mutuleasadavid/Audiofrequency-Oscillator/poze layout/TOPSMTOP.jpg

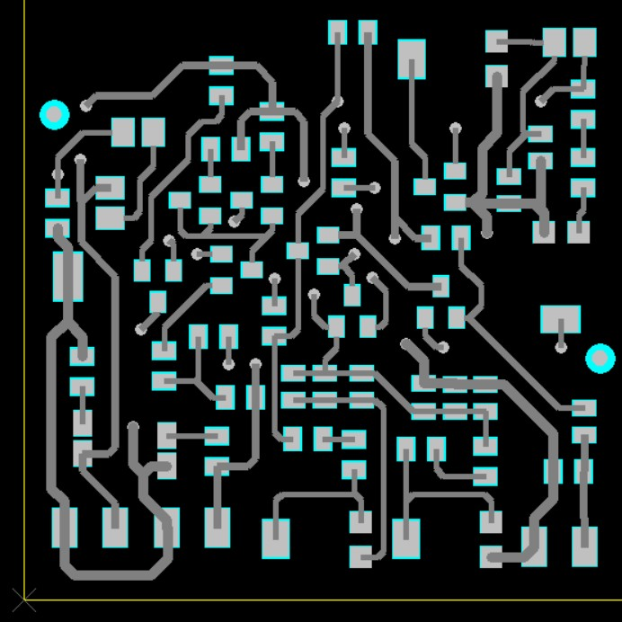
poze layout/TOPSMTOP.jpg
