mutuleasadavid/Audiofrequency-Oscillator/README.md

# Audiofrequency-Oscillator
I designed an analog audiofrequency oscillator with variable frequency and amplitude. I also projected the PCB for the SMD components.
