mutuleasadavid/Audiofrequency-Oscillator/Documentation.pdf

Universitatea Națională de Știință și Tehnologie POLITEHNICA București Facultatea E.T.T.I.
Anul universitar 2025-2026

# Circuite electronice fundamentale 2 - Proiect

# Proiectarea și realizarea

# unui oscilator de audiofrecvență

# cu semnal sinusoidal

N=3

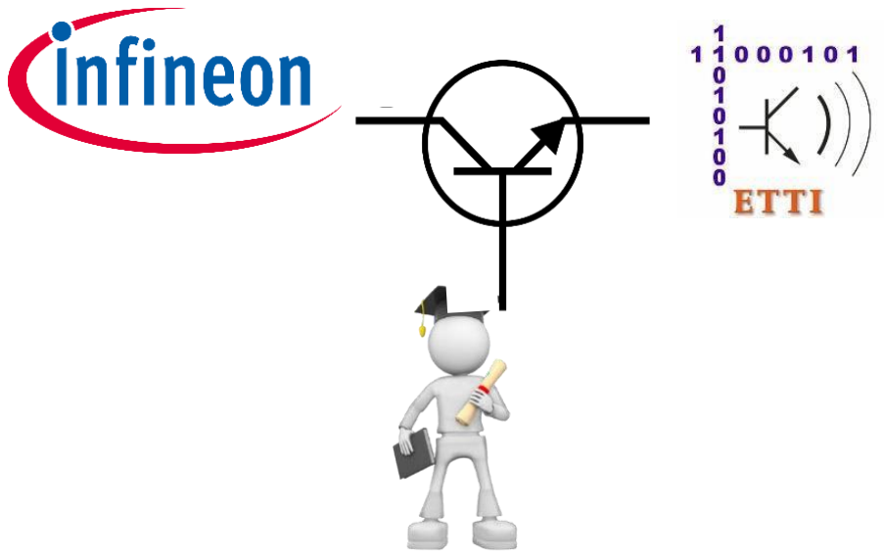
[picture p2: figure]

Coordonatori științifici | Student
Prof. dr. ing. Dragoș Dobrescu | Mutuleasa David-Andrei
Ș.l. dr. ing. Mădălin Moise | Grupa 431B

Îndrumar realizat de ETTI în parteneriat cu Infineon România

## Cuprins

1. Introducere | pagina 3
2. Analiza a 3 retele | pagina 3
3. Schema bloc | pagina 5
4. Punct static de functionare | pagina 7
5. Simulari | pagina 8
6. Bill of Materials | pagina 11
7. Imagini realizare PCB | pagina 11
8. Manual de utilizare | pagina 14
9. Concluzii | pagina 14
10. Bibliografie | pagina 14

1. Introducere

Un oscilator de audiofrecvență este un circuit electronic conceput pentru a genera semnale electrice periodice (de obicei sub formă de undă sinusoidală, dreptunghiulară sau triunghiulară) într-un domeniu de frecvență perceptibil de urechea umană. Acest interval, numit spectrul audio, se situează aproximativ între 20 Hz și 20.000 Hz (20 kHz).
Oscilatorul nu necesită un semnal de intrare pentru a putea produce forma de undă dorită, acest lucru fiind realizat prin intermediul rețelei de reacție pozitivă care folosește diferite configurații cunoscute pentru a realiza acest lucru (Wien, Dublu T, cu 3 celule de defazaj etc.). Alături de aceasta, vom avea nevoie și de o rețea de reacție negativă în cadrul amplificatorului și de a îndeplini condiția lui Barkhausen pentru a menține oscilațiile.
În cadrul acestui proiect, am realizat un oscilator folosind o punte Wien. Atât frecvența (300Hz-3KHz), cât și amplitudinea (0-300mV) pot fi reglate prin intermediul potentiometrelor folosite în circuit.

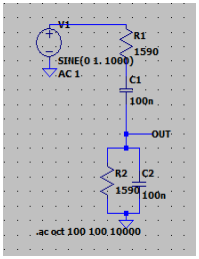
[picture p3: figure]
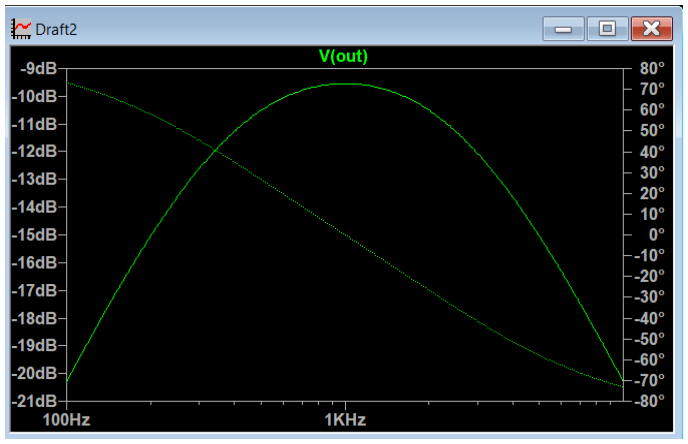
[picture p4: figure]

2. Analiza a 3 retele.

2.1 Retea Wien.

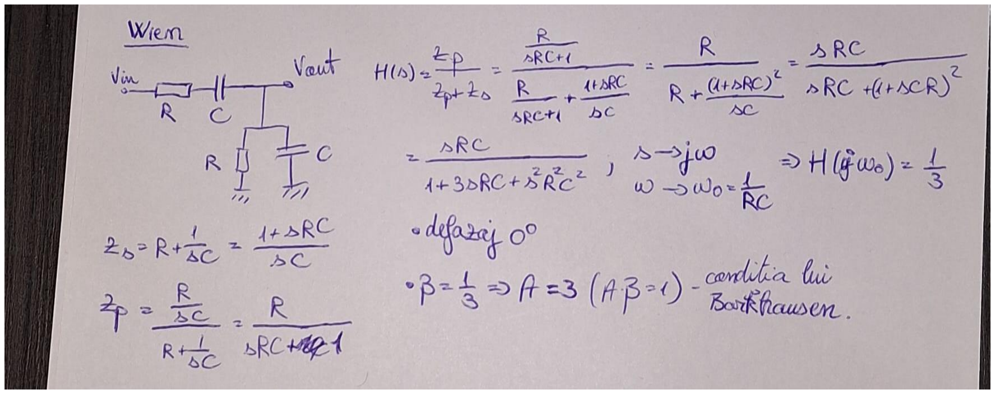
[picture p5: figure]
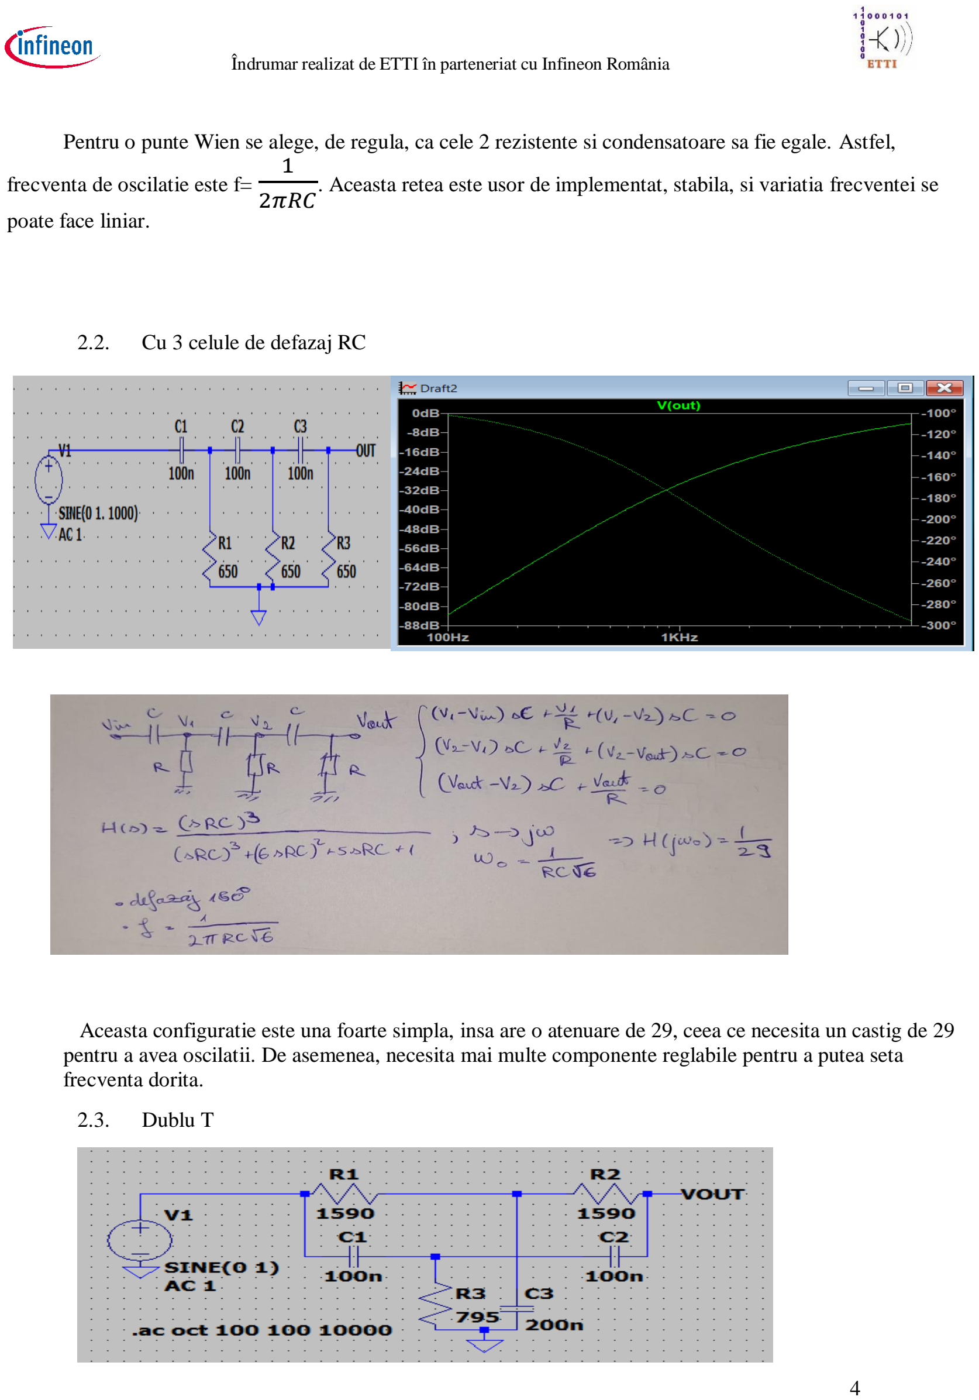
[picture p6: page 4]

Pentru o punte Wien se alege, de regula, ca cele 2 rezistente si condensatoare sa fie egale. Astfel,

frecventa de oscilatie este f=

1

### 2πRC

. Aceasta retea este usor de implementat, stabila, si variatia frecventei se

poate face liniar.

2.2. Cu 3 celule de defazaj RC

h

Aceasta configuratie este una foarte simpla, insa are o atenuare de 29, ceea ce necesita un castig de 29 pentru a avea oscilatii. De asemenea, necesita mai multe componente reglabile pentru a putea seta frecventa dorita.

2.3. Dublu T

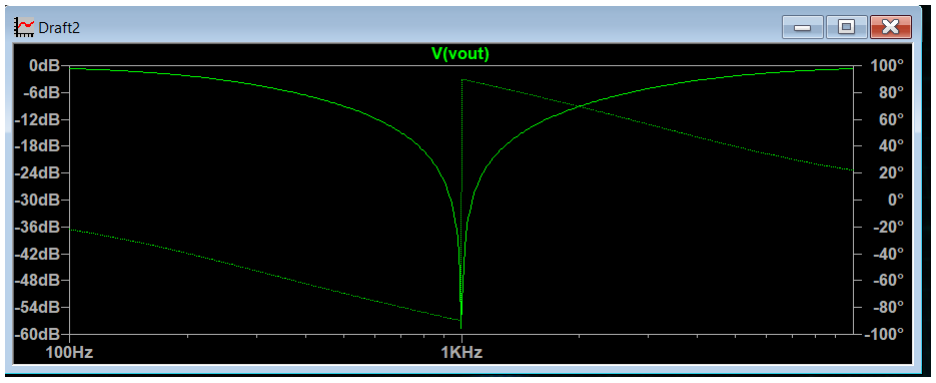
[picture p7: figure]

H(s) =

s

2+ω0

2

s

2+4sω0+ω0

2

ω0 =

1
RC

f =

1
2πRC

Aceasta retea trebuie folosita in reactia negativa a

amplificatorului, iar reactia pozitiva este de regula un divizor de tensiune pentru a porni oscilatiile. Este un filtru notch (crestatura) care blocheaza frecventa centrala ( de oscilatie). Cu ajutorul acestei retele dublu T se pot construi oscilatoare foarte precise, insa complexe. Sunt necesare componente cu tolerante foarte mici, deoarece orice erori pot scadea semnificati adancimea crestaturii. De asemenea, este destul de dificil de ajustat frecventa oscilatiilor fara a dezechilibra reteaua.

3. Schema bloc

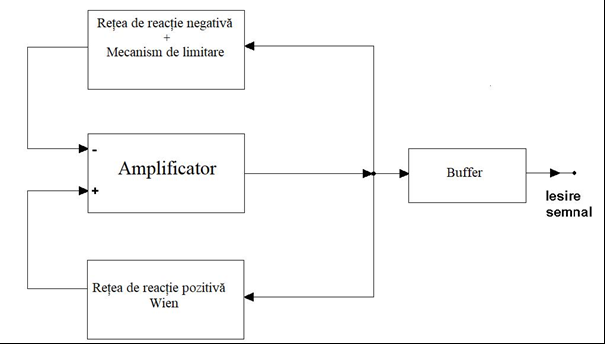
[picture p8: figure]

3.1. Schema electrica

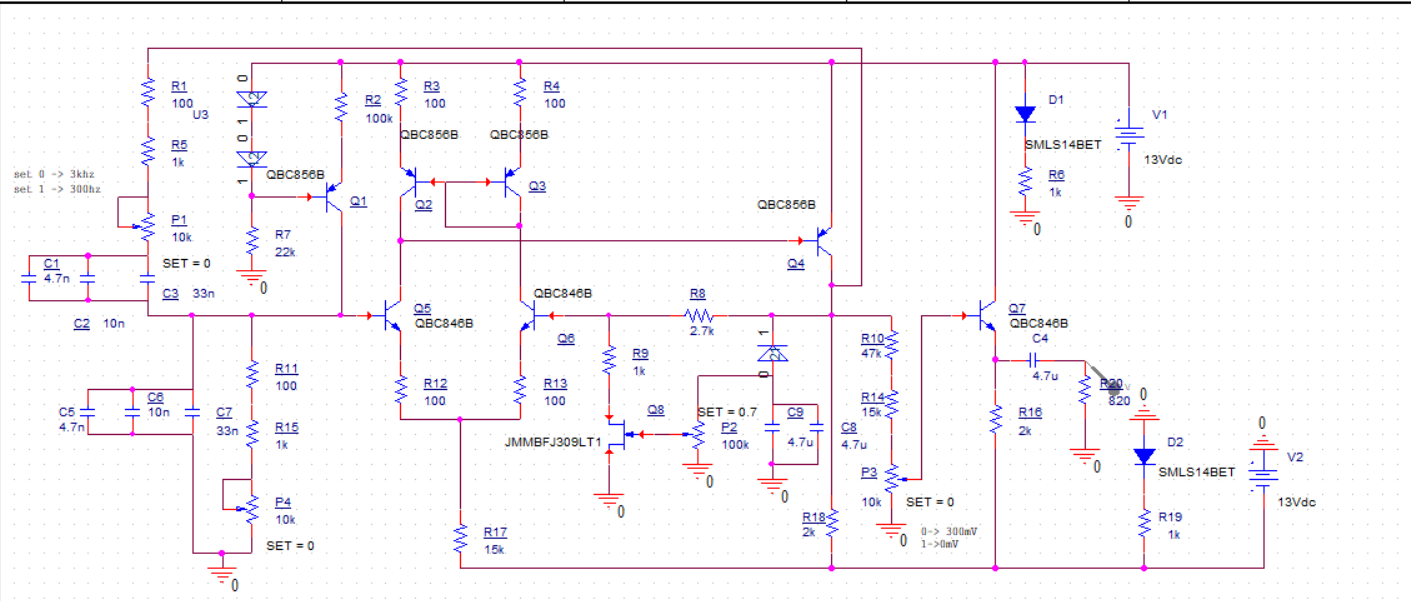
[picture p9: figure]

3.1.1 Retea reactie pozitiva

Aceasta este formata din R1,R5,P1,C1,C2,C3 ; R11,R15,P4,C5,C6,C7. Este o punte Wien pe care am ales-o datorita usurintei implementarii si reglarii frecventei. Frecventa oscilatiior este f =

1
2πRC

. Prin
modificarea potentiometrelor in acelasi timp, avem un Rmin=1100Ω si Rmax=11100Ω. Cele 3 condensatoare sunt in paralel si au capacitatea totala de 47.7nF. Conform formulei vom obtine o frecventa variabila in intervalul (300,6Hz ; 3033.25Hz).

3.1.2 Retea reactie negativa

Datorita stabilitatii termice, am optat pentru un mecanism de control automat al amplificarii. Avem nevoie de un mecanism de limitare astfel incat oscilatiile sa nu se stinga sau varfurile acesteia sa fie taiate. Principiul acestui mecanism se bazeaza pe rⅆs variabil al tranzistorului TEC-J. Dioda va redresa semnalul sinusoidal, monoalternant, iar valoarea de varf va fi retinuta in condensator. Aceasta valoare de curent continuu va intra in baza tranzitorului, modificand valoarea rezistentei. Daca VGS este 0, rezistenta are valoare minima, iar cand aceasta tensiune devine negativa, valoarea rezistentei drena-sursa creste. Astfel, amplificarea este controlata pentru a mentine oscilatiile, dar si a le limita amplitudinea.

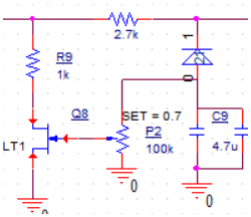
[picture p10: figure]

3.1.3 Amplificatorul

Amplificatorul contine mai multe etaje. Primul este un etaj diferential, cu rolul de a adapta impedanta si de conversie. Acesta are o impedanta de intrare ridicata, necesara pentru a nu incarca puneta Wien. Fiind un etaj de transconductanta, acesta realizeaza conversia tensiunii de intrare in curent. Etajul diferential este urmat de un etaj emitor comun cu o amplificare mare si realizeaza conversia inapoi in tensiune.

3.1.4. Buffer/Etaj iesire.

Inainte de acest etaj, am folosit un divizor de tensiune pentru a seta amplitudinea dorita a semnalului. Avand o amplificare aproximativ unitara in tensiune, rolul acestui etaj este de a amplifica in curent. Are impendanta foarte mare de intrare si mica de iesire, ideal pentru un etaj final la care vom conecta sarcina.

4. Punct static de functionare.

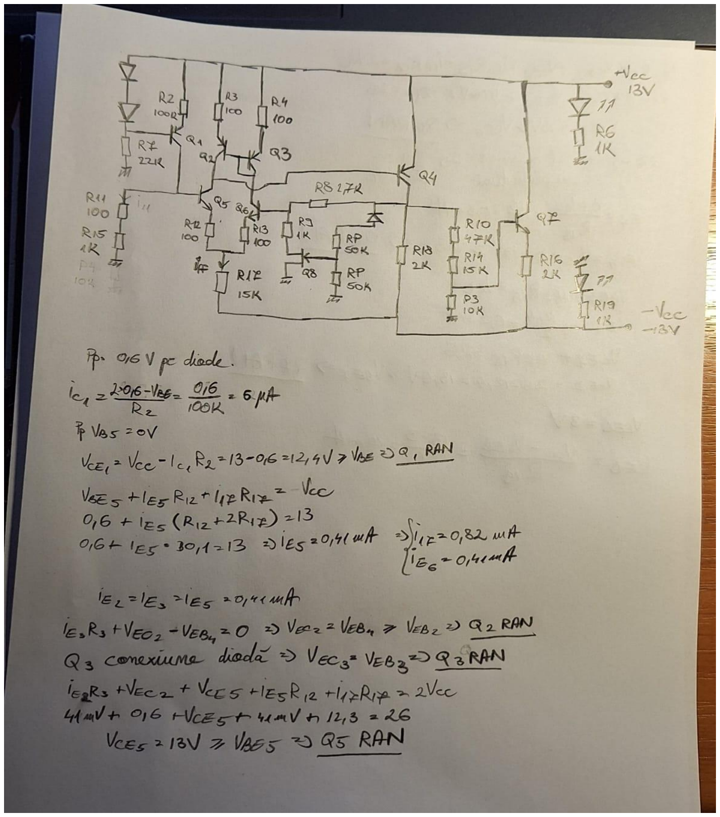
[picture p11: figure]
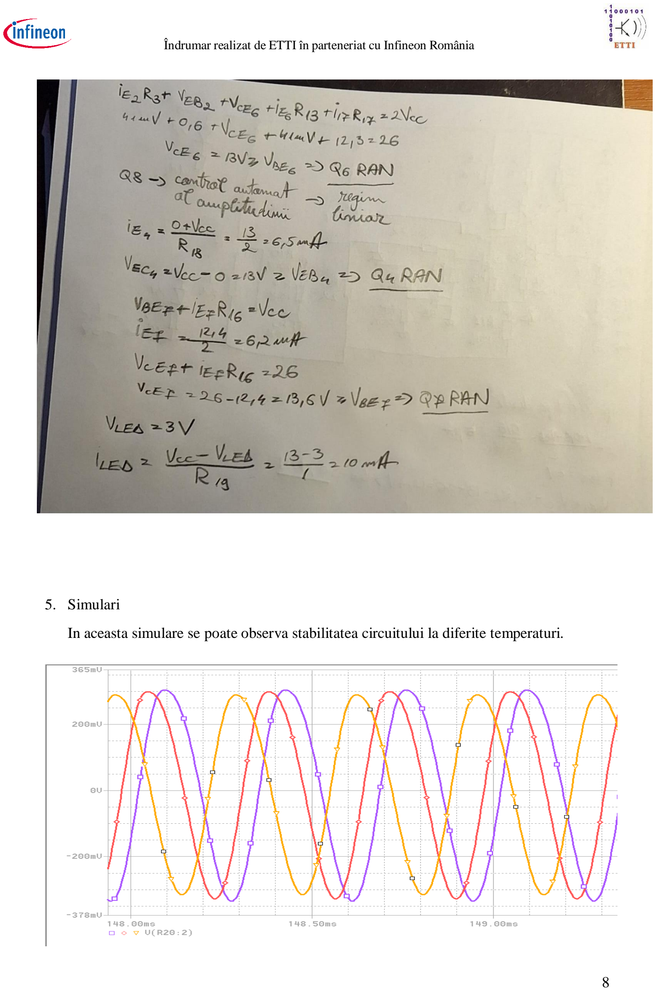
[picture p12: page 8]

5. Simulari

In aceasta simulare se poate observa stabilitatea circuitului la diferite temperaturi.

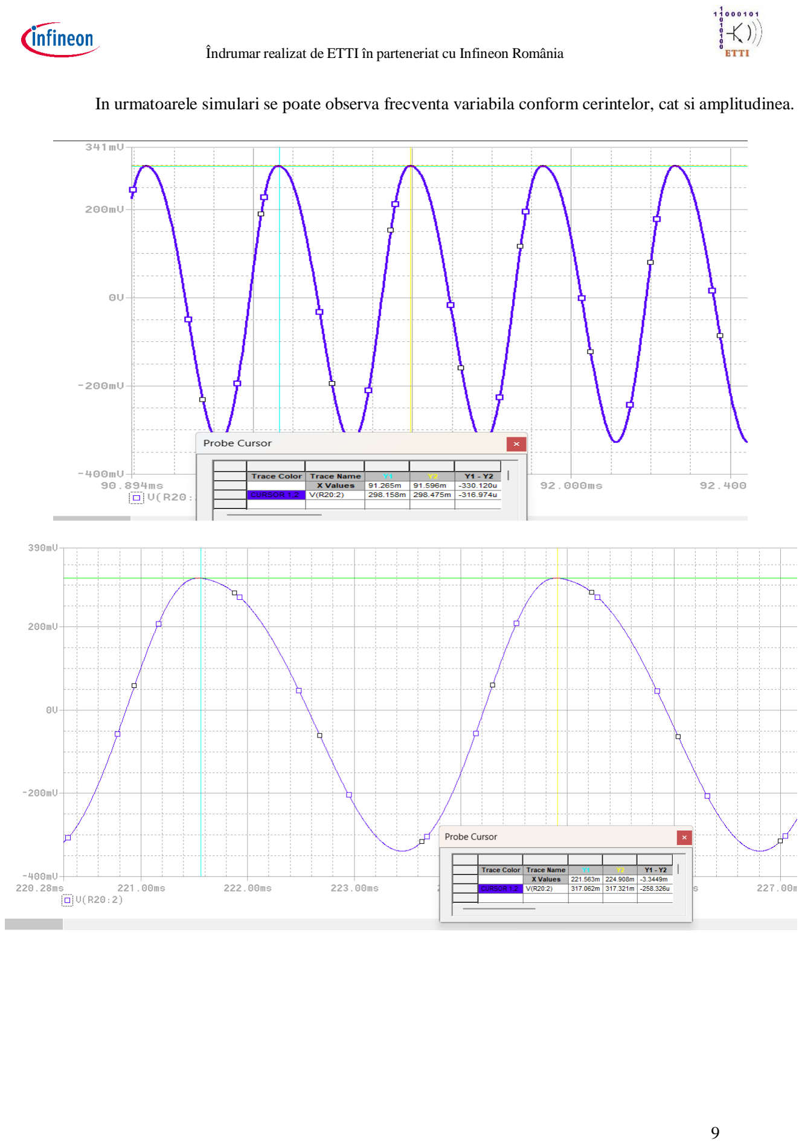
[picture p13: page 9]

In urmatoarele simulari se poate observa frecventa variabila conform cerintelor, cat si amplitudinea.

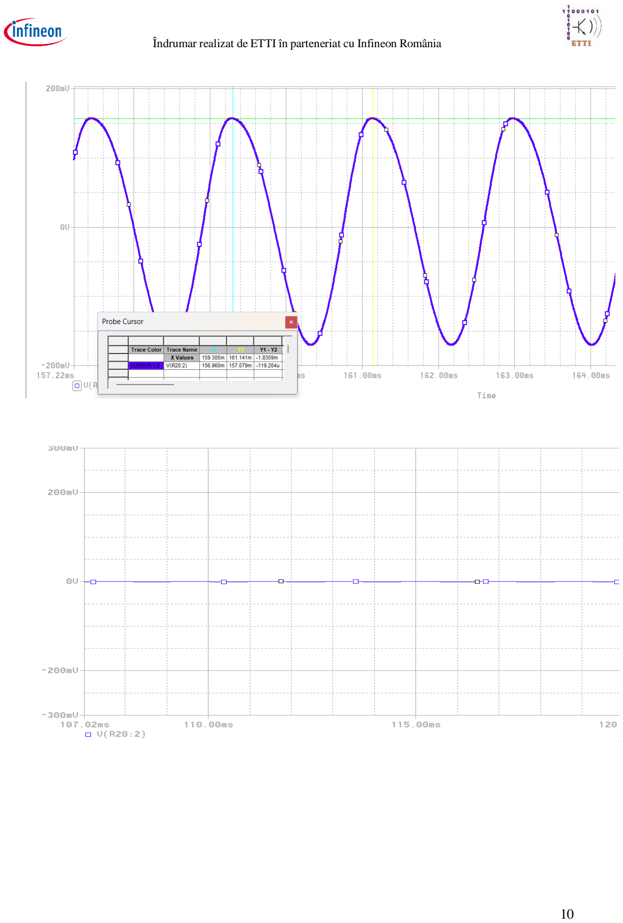
[picture p14: page 10]

6. Bill of Materials
7. Imagini realizare PCB
Board Outline(BO) | Bottom(BOT)

Nr.

Crt. | Nume | Catalog | Cod distrib | Nume prod | Prod | Clasă | Qty fix
11 | 100 | (LINK) (https://www.tme.eu/ro/details/smd0805-100r/rezistente-smd-0805/royal-ohm/0805s8j0101t5e/) | SMD0805-100R-5% | 0805S8J0101T5E | ROYAL OHM | rezistor | 6
18 | 820 | (LINK) (https://www.tme.eu/ro/details/smd0805-820r/rezistente-smd-0805/royal-ohm/0805s8j0821t5e/) | SMD0805-820R-5% | 0805S8J0821T5E | ROYAL OHM | rezistor | 1
20 | 1k | (LINK) (https://www.tme.eu/ro/details/smd0805-1k/rezistente-smd-0805/royal-ohm/0805s8j0102t5e/) | SMD0805-1K-5% | 0805S8J0102T5E | ROYAL OHM | rezistor | 5
23 | 2k | (LINK) (https://www.tme.eu/ro/details/smd0805-2k/rezistente-smd-0805/royal-ohm/0805s8j0202t5e/) | SMD0805-2K-5% | 0805S8J0202T5E | ROYAL OHM | rezistor | 2
25 | 2.7k | (LINK) (https://www.tme.eu/ro/details/smd0805-2k7/rezistente-smd-0805/royal-ohm/0805s8j0272t5e/) | SMD0805-2K7-5% | 0805S8F2701T5E | ROYAL OHM | rezistor | 1
34 | 15k | (LINK) (https://www.tme.eu/ro/details/smd0805-15k/rezistente-smd-0805/royal-ohm/0805s8j0153t5e/) | SMD0805-15K-5% | 0805S8J0153T5E | ROYAL OHM | rezistor | 2
35 | 22k | (LINK) (https://www.tme.eu/ro/details/smd0805-22k/rezistente-smd-0805/royal-ohm/0805s8j0223t5e/) | SMD0805-22K-5% | 0805S8J0223T5E | ROYAL OHM | rezistor | 1
36 | 47k | (LINK) (http://www.tme.eu/ro/details/smd0805-47k/rezistente-smd-0805/royal-ohm/0805s8j0473t5e/) | SMD0805-47K-5% | 0805S8J0473T5E | ROYAL OHM | rezistor | 1
38 | 100k | (LINK) (https://www.tme.eu/ro/details/smd0805-100k/rezistente-smd-0805/royal-ohm/0805s8j0104t5e/) | SMD0805-100K-5% | 0805S8J0104T5E | ROYAL OHM | rezistor | 1
53 | 10k | (LINK) (http://www.tme.eu/ro/details/3314g-1-103e/trimere-smd-cu-o-singura-tura/bourns/) | 3314G-1-103E | 3314G-1-103E | BOURNS | potențiometru | 3
55 | 100k | (LINK) (http://www.tme.eu/ro/details/ts53yl100k/trimere-smd-cu-o-singura-tura/vishay/ts53yl104mr10/) | TS53YL104MR10 | TS53YL104MR10 | VISHAY | potențiometru | 1
64 | 4.7nF | (LINK) (https://www.tme.eu/ro/details/cl21b472kbannnc/condensatoare-mlcc-smd-0805/samsung/) | CL21B472KBANNNC | CL21B472KBANNNC | SAMSUNG | condensator | 2
66 | 10nF | (LINK) (https://www.tme.eu/ro/details/cl21b103kbannnd/condensatoare-mlcc-smd-0805/samsung/) | CL21B103KBANNND | CL21B103KBANNND | SAMSUNG | condensator | 2
68 | 33nF | (LINK) (https://www.tme.eu/ro/details/vj0805y333kxacw1bc/condensatoare-mlcc-smd-0805/vishay/) | VJ0805Y333KXACW1BC | VJ0805Y333KXACW1BC | VISHAY | condensator | 2
75 | 4.7uF | (LINK) (https://www.tme.eu/ro/details/cl21a475kaqnnng/condensatoare-mlcc-smd-0805/samsung/) | CL21A475KAQNNNG | CL21A475KAQNNNG | SAMSUNG | condensator | 3
77 | 4148 | (LINK) (http://www.tme.eu/ro/details/1n4148-0805/diode-universale-smd/dc-components/cd4148ws0805c/) | 1N4148-0805 | CD4148WS(0805C) | DC Components | diodă pn | 3
78 | LED | (LINK) (https://www.tme.eu/ro/details/of-smd2012b/diode-led-smd-colorate/optoflash/) | OF-SMD2012B | OF-SMD2012B | OPTOFLASH | LED | 2
86 | PNP | (LINK) (http://www.tme.eu/ro/details/bc856b-dio/tranzistori-smd-pnp/diotec-semiconductor/bc856b/) | BC856B | BC856B | DIOTEC | tranzistor bipolar | 4
87 | NPN | (LINK) (https://www.tme.eu/ro/details/bc846b-dio/tranzistori-smd-npn/diotec-semiconductor/bc846b/) | BC846B | BC846B | DIOTEC | tranzistor bipolar | 3
89 | JFET N- | (LINK) (http://www.tme.eu/ro/details/mmbfj309lt1g/tranzistori-canal-n-smd/on-semiconductor/) | MMBFJ309LT1G | MMBFJ309LT1G | ON Semiconductor | tranzistor NJFET | 1

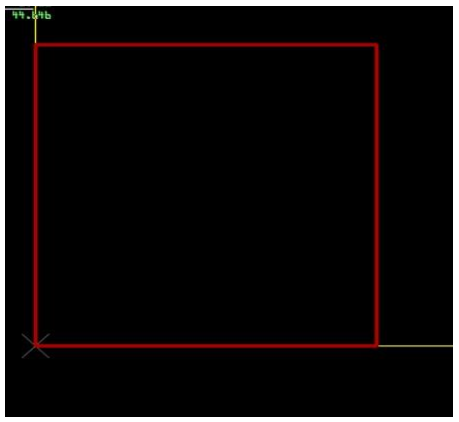
[picture p15: figure]
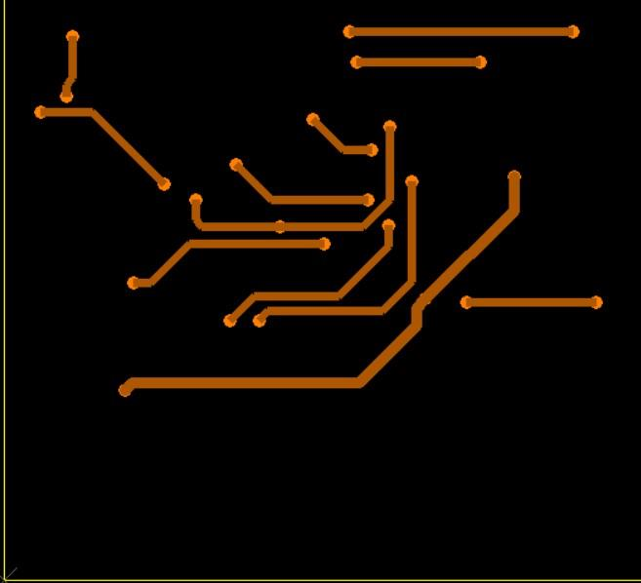
[picture p16: figure]
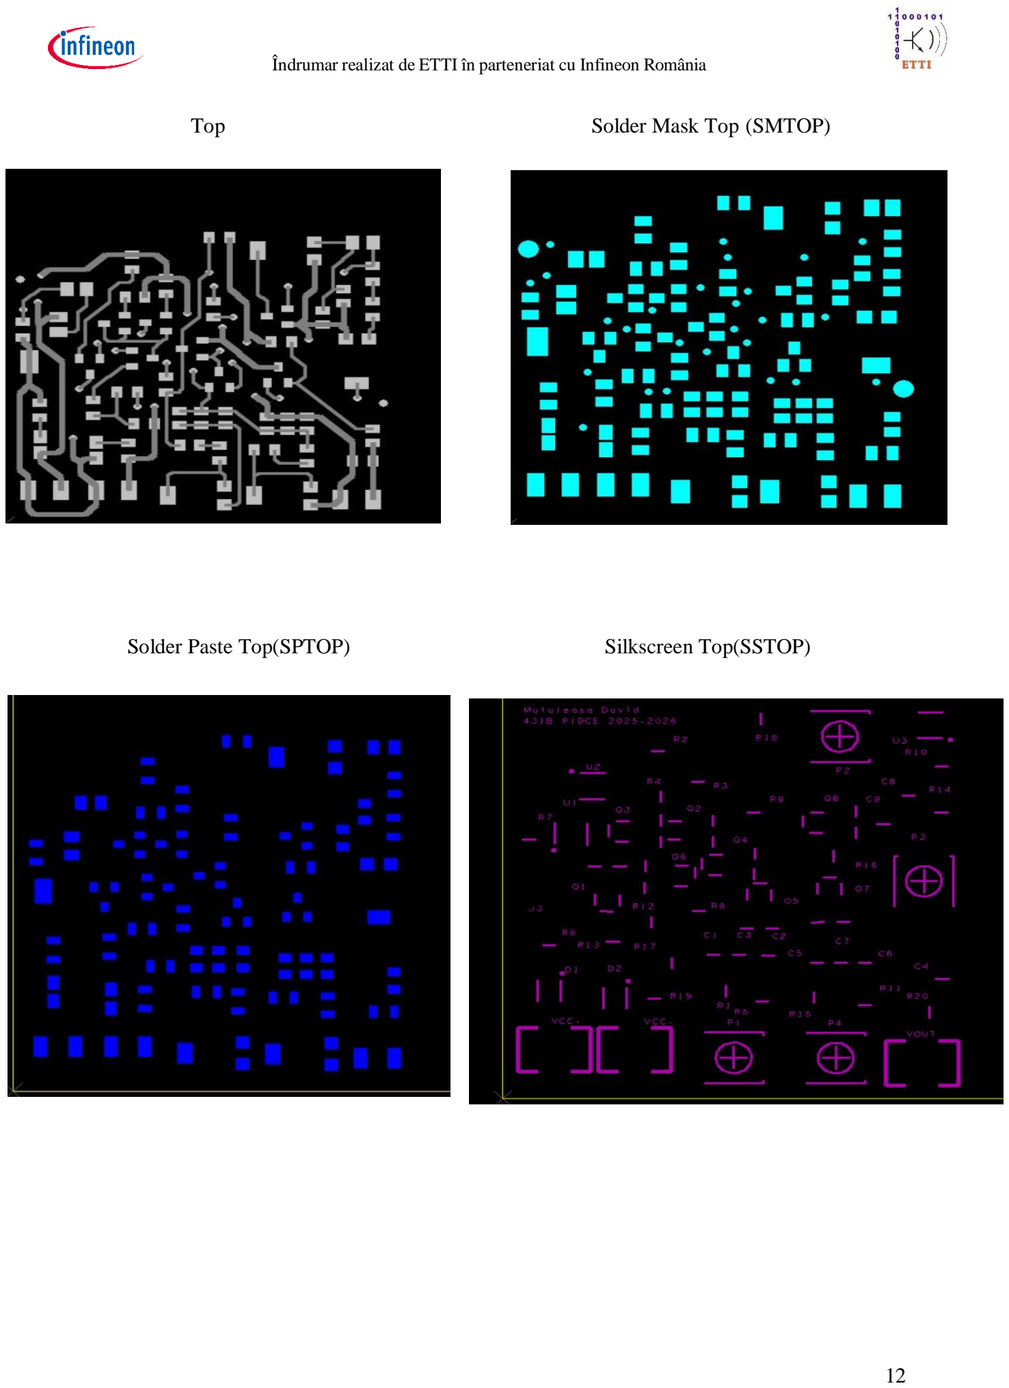
[picture p17: page 12]

Top | Solder Mask Top (SMTOP)
Solder Paste Top(SPTOP) | Silkscreen Top(SSTOP)

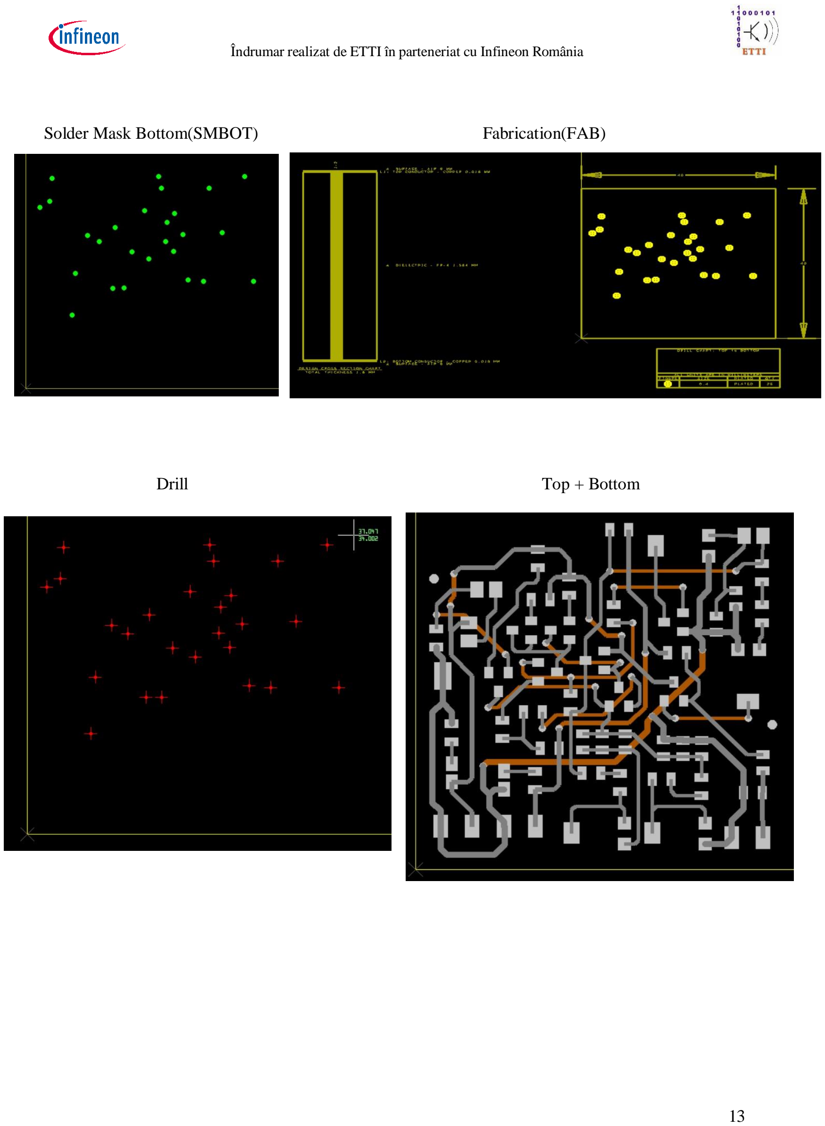
[picture p18: page 13]

Solder Mask Bottom(SMBOT) | Fabrication(FAB)
Drill | Top + Bottom

8. Manual de utilizare

Oscilatorul de audiofrecvență cu semnal sinusoidal a fost proiectat pentru a funcționa optim intr-o

conexiune bipolară la tensiunea de alimentare de 11V unde se va conecta o rezistență de sarcină de

800Ω.

- Se vor conecta bornele „–” la borna GND;
- VCC se va conecta la o tensiune de 13V;
- VEE se va conecta la o tensiune de –13V;
- A nu se atinge componentele sau conexiunile în timpul funcționării;
- A se manevra ținandu-se de marginile plăcii de asamblare;
- Nu se recomandă schimbarea componentelor circuitului; in acest caz, comportamentul nu poate fi

determinat;

- A se feri de umezeală si de expunerea îndelungată la razele soarelui;
- A nu se lăsa la îndemâna copiilor, decât sub supravegherea unui adult
9. Concluzii

Acest proiect a validat funcționarea unui oscilator de tip Punte Wien în banda de audiofrecvență (300 Hz – 3 kHz), utilizând tranzistoare bipolare. Aplicarea criteriului lui Barkhausen a asigurat baza teoretică pentru amorsarea oscilațiilor, aspect confirmat ulterior prin simulare. Rezultatele au demonstrat stabilitatea circuitului, liniaritatea etajului de amplificare și eficiența reacției negative în minimizarea distorsiunilor semnalului de ieșire. Pentru a putea pune in functiune acest oscilator, am realizat si PCB-ul corespunzator.

10. Bibliografie
1. http://www.dce.pub.ro;
2. https://wiki.dcae.pub.ro/index.php/Cosmin_Popa
3. https://www.electronics-tutorials.ws/oscillator/wien_bridge.html
4. https://www.geeksforgeeks.org/electrical-engineering/wien-bridge-oscillator/
