mutuleasadavid/Audiofrequency-Oscillator/poze layout/BO.jpg

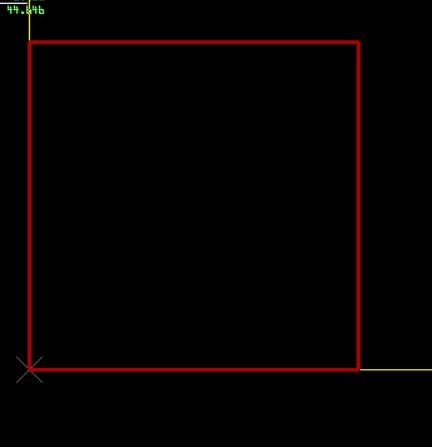
poze layout/BO.jpg
