mutuleasadavid/Audiofrequency-Oscillator/poze layout/DRILL.jpg

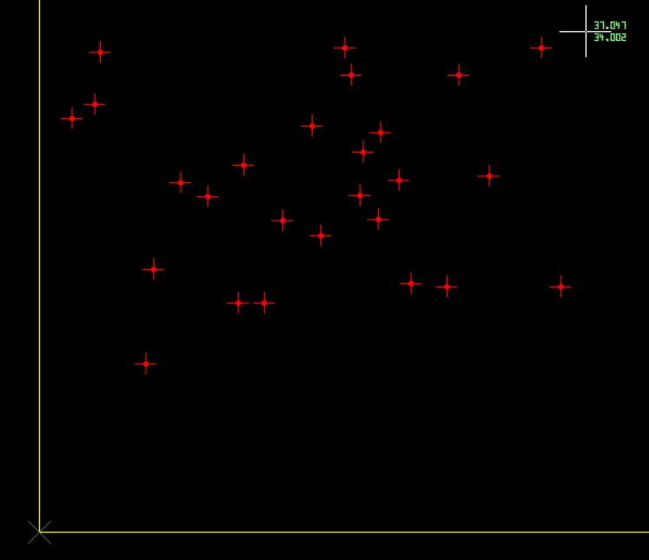
poze layout/DRILL.jpg
