mutuleasadavid/Audiofrequency-Oscillator/poze layout/FAB.jpg

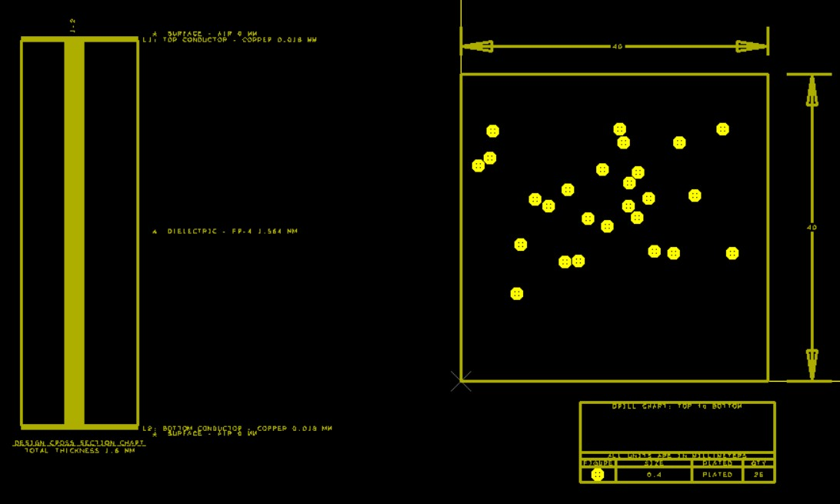
poze layout/FAB.jpg
