mutuleasadavid/Audiofrequency-Oscillator/poze layout/SMBOT.jpg

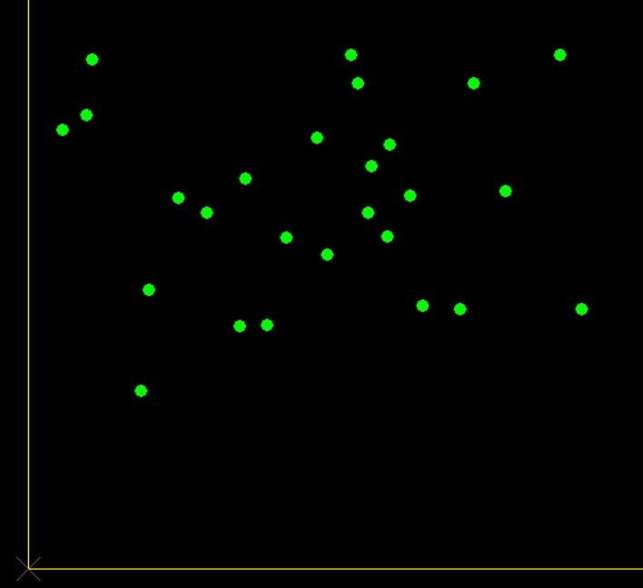
poze layout/SMBOT.jpg
