mutuleasadavid/Audiofrequency-Oscillator/poze layout/SMTOP.jpg

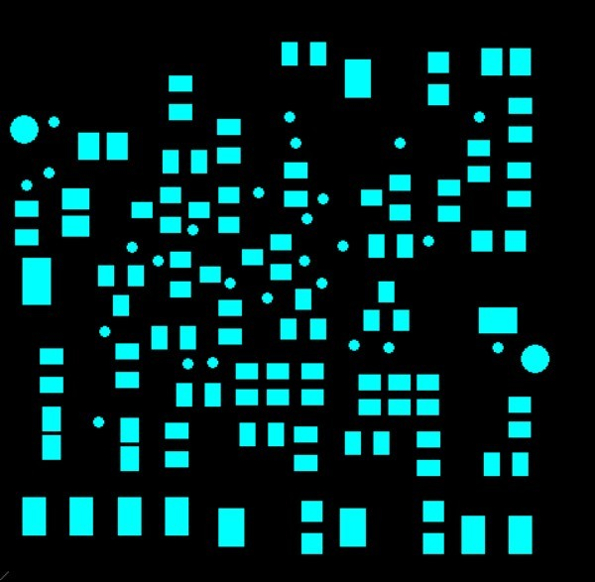
poze layout/SMTOP.jpg
