mutuleasadavid/Audiofrequency-Oscillator/poze layout/SPTOP.jpg

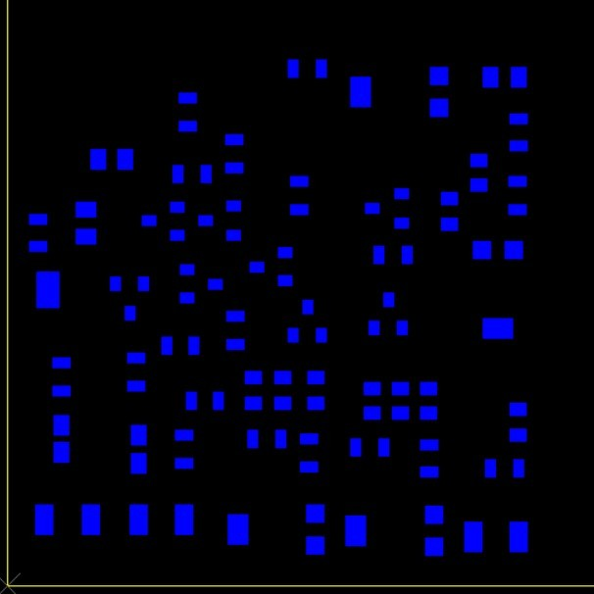
poze layout/SPTOP.jpg
