mutuleasadavid/Audiofrequency-Oscillator/poze layout/SSTOP.jpg

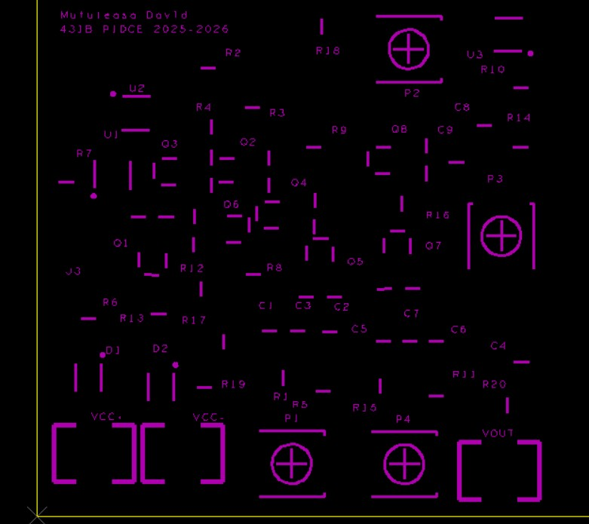
poze layout/SSTOP.jpg
