mutuleasadavid/Audiofrequency-Oscillator/poze layout/SSTOPSMTOP.jpg

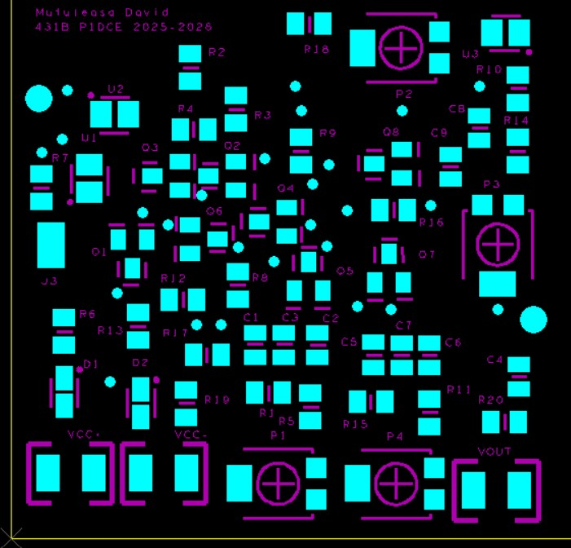
poze layout/SSTOPSMTOP.jpg
