mutuleasadavid/Audiofrequency-Oscillator/poze layout/TOP.jpg

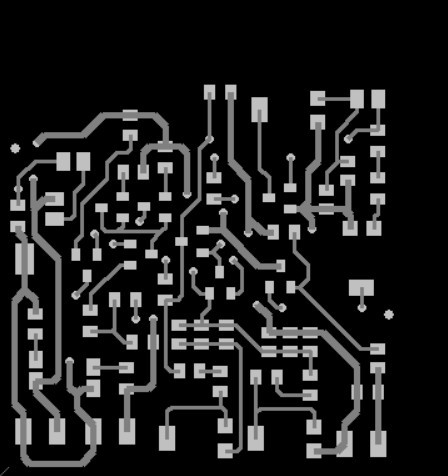
poze layout/TOP.jpg
