mutuleasadavid/Audiofrequency-Oscillator/poze layout/TOPBOT.jpg

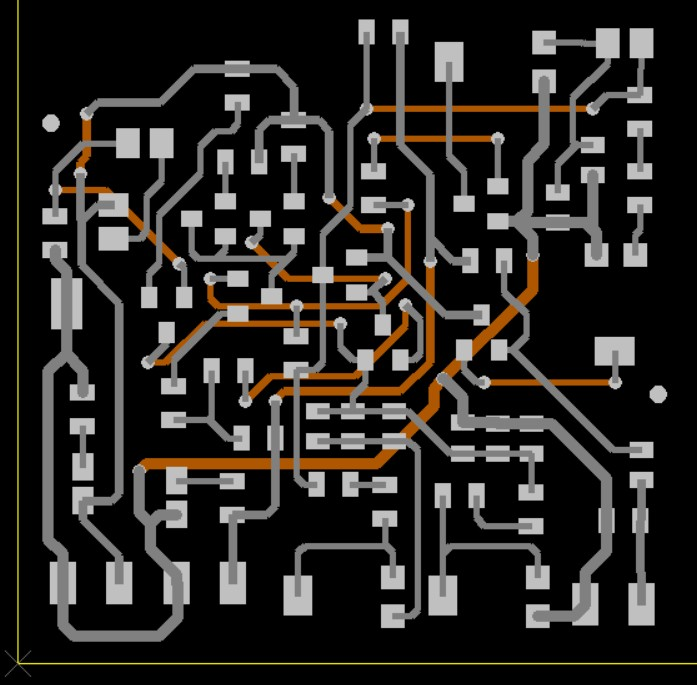
poze layout/TOPBOT.jpg
