mutuleasadavid/Audiofrequency-Oscillator/poze layout/TOPDRILL.jpg

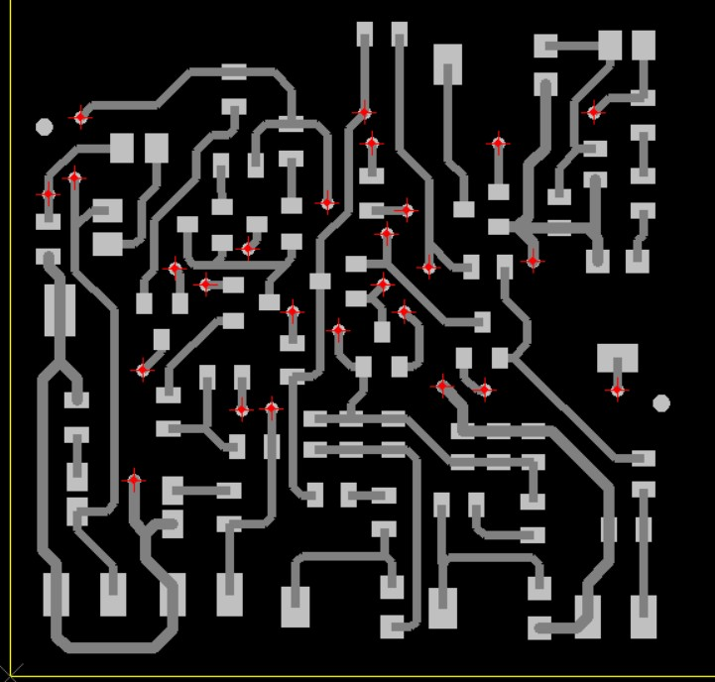
poze layout/TOPDRILL.jpg
