mutuleasadavid/Audiofrequency-Oscillator/poze layout/TOPSPTOP.jpg

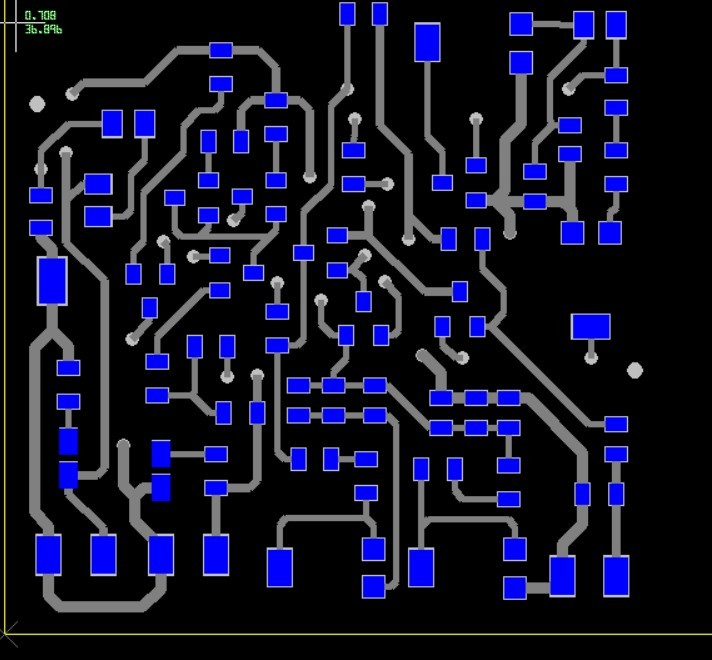
poze layout/TOPSPTOP.jpg
