mutuleasadavid/Audiofrequency-Oscillator/poze simulari/3khz300mv.jpg

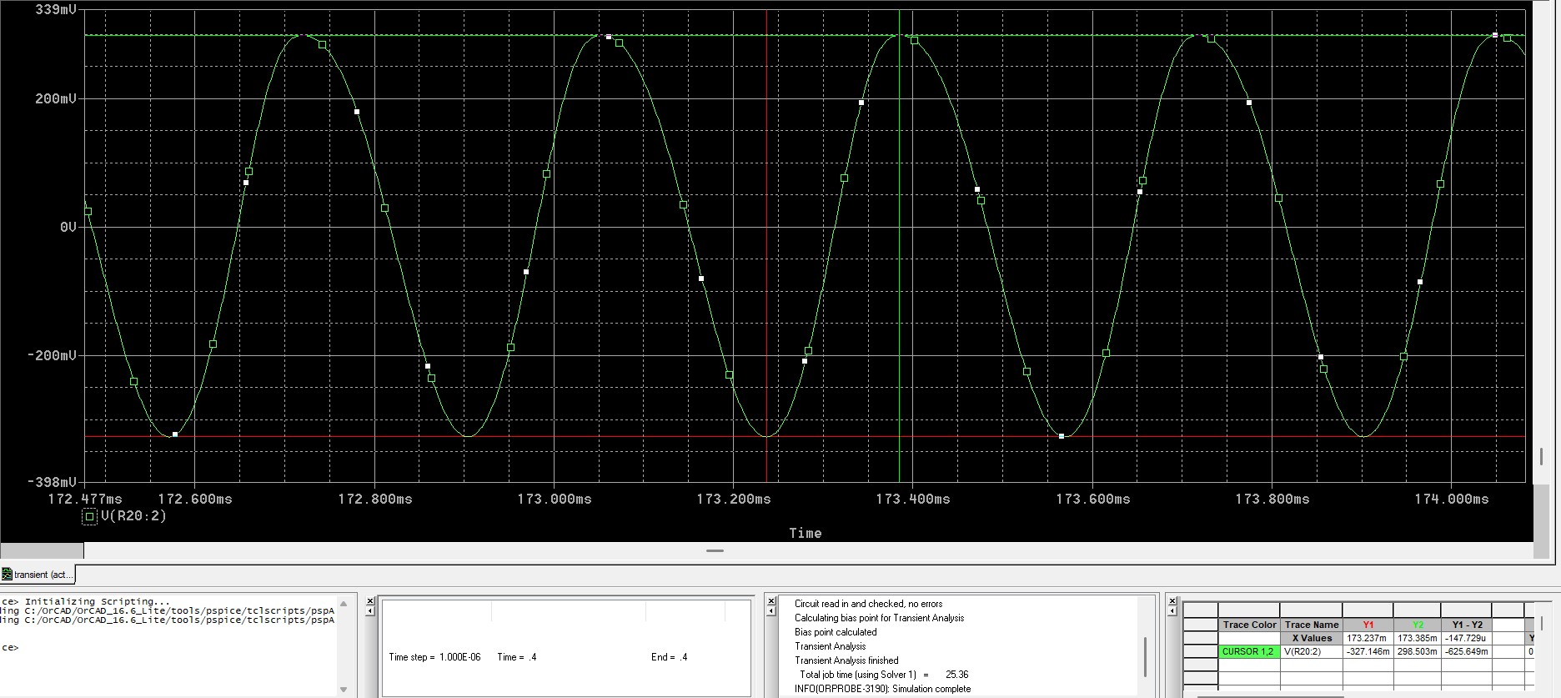
poze simulari/3khz300mv.jpg
