mutuleasadavid/Audiofrequency-Oscillator/poze simulari/3khz.jpg

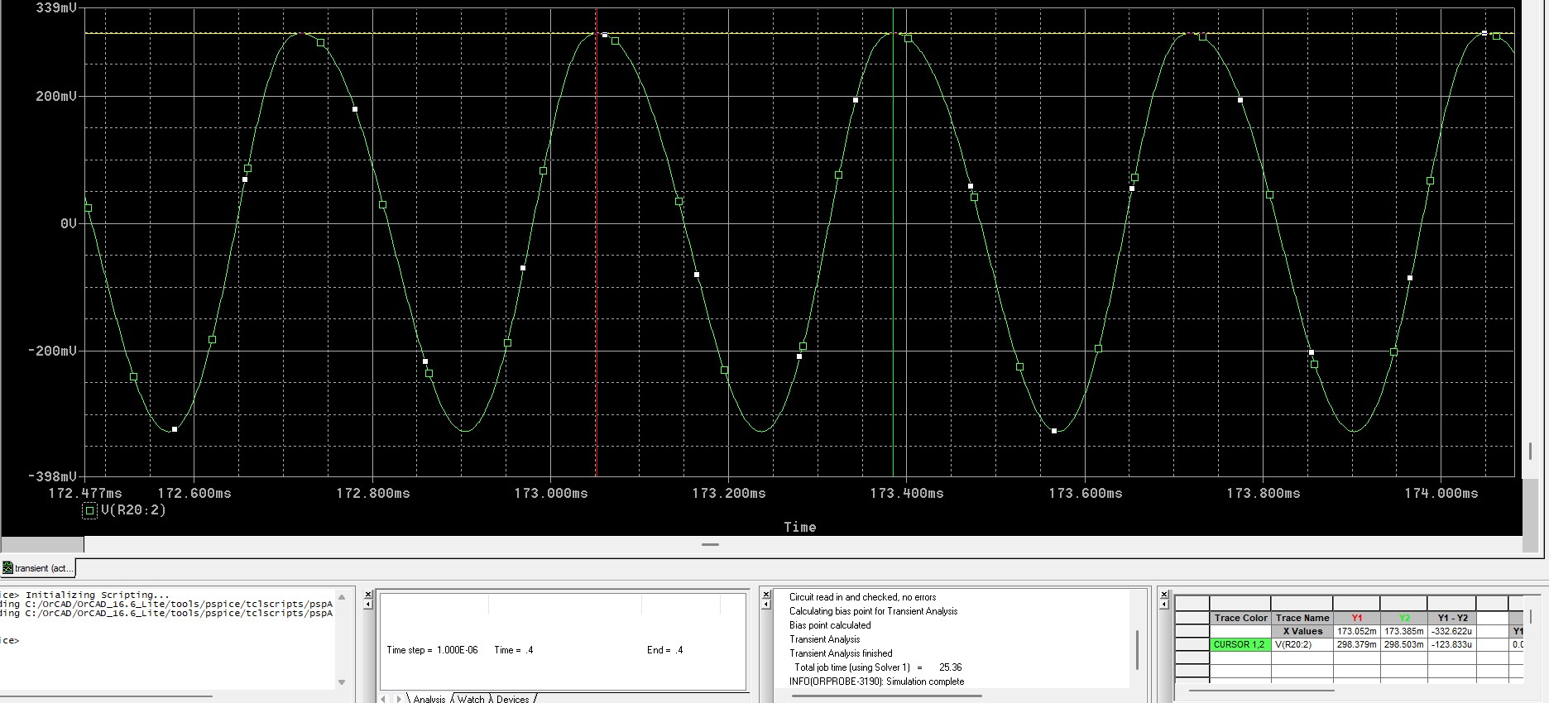
poze simulari/3khz.jpg
