mutuleasadavid/Audiofrequency-Oscillator/poze simulari/300hz300mv.jpg

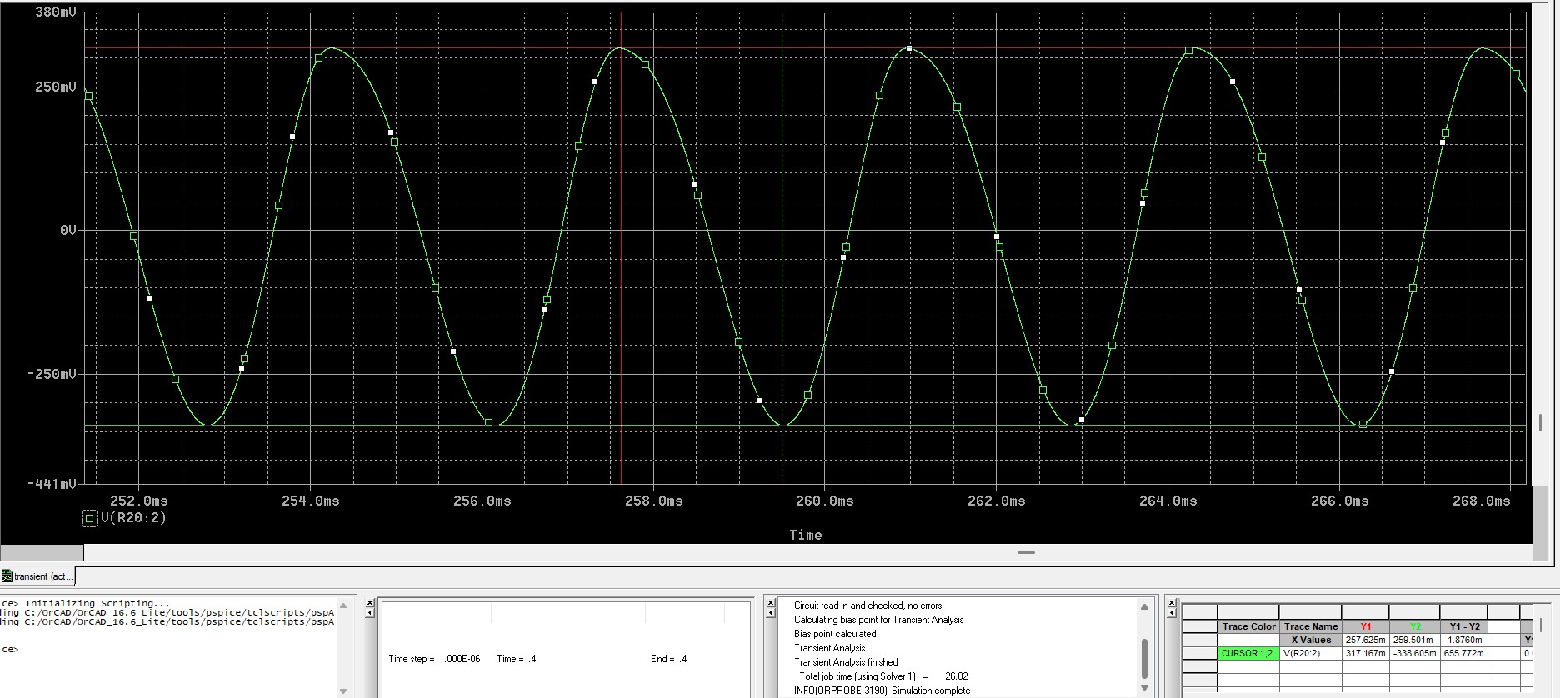
poze simulari/300hz300mv.jpg
