mutuleasadavid/Audiofrequency-Oscillator/poze simulari/300hz.jpg

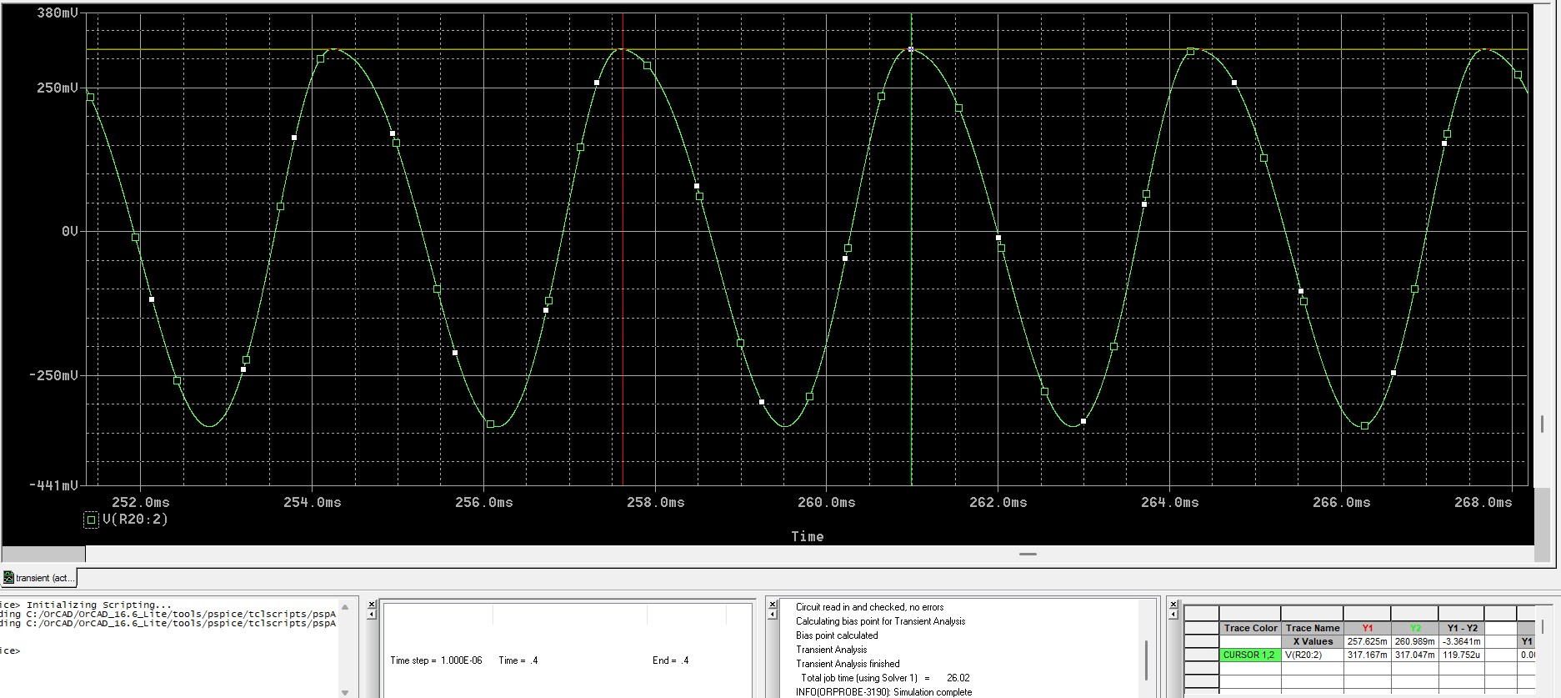
poze simulari/300hz.jpg
