mutuleasadavid/Audiofrequency-Oscillator/poze simulari/temperature.jpg

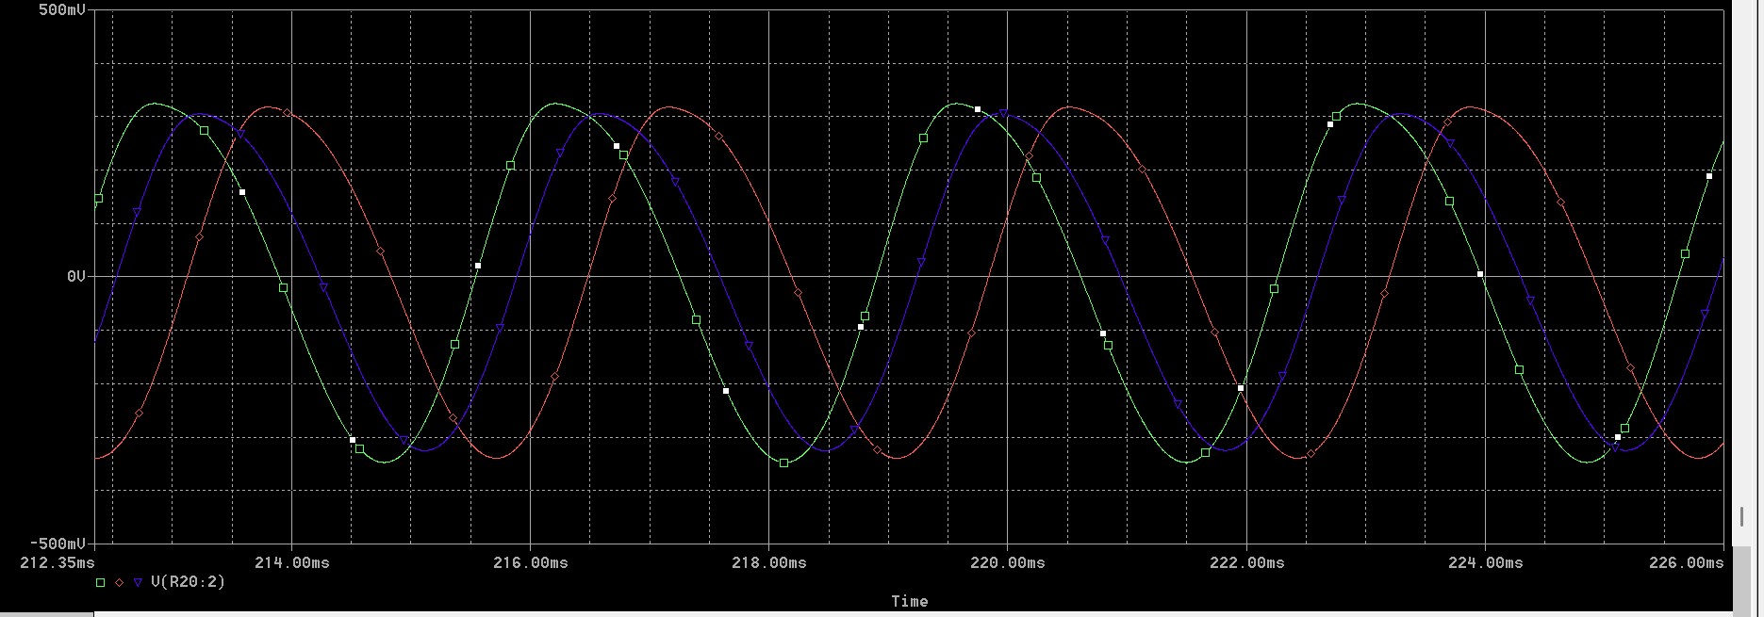
poze simulari/temperature.jpg
