mutuleasadavid/Audiofrequency-Oscillator/(list of files, drawings)

Other design files:
Schematic/CIRCUIT.DSN
Schematic/circuit.opj
Schematic/SCH_TRANSFER.DSN
Schematic/sch_transfer.opj
